Immortals-Robotics/Mikona/README.md

# ImmortalsMikona
Immortals kicker board known as Mikona
