Immortals-Robotics/Mikona/mikona.kicad_pcb

## KiCad design mikona.kicad_pcb (2024-02-27)

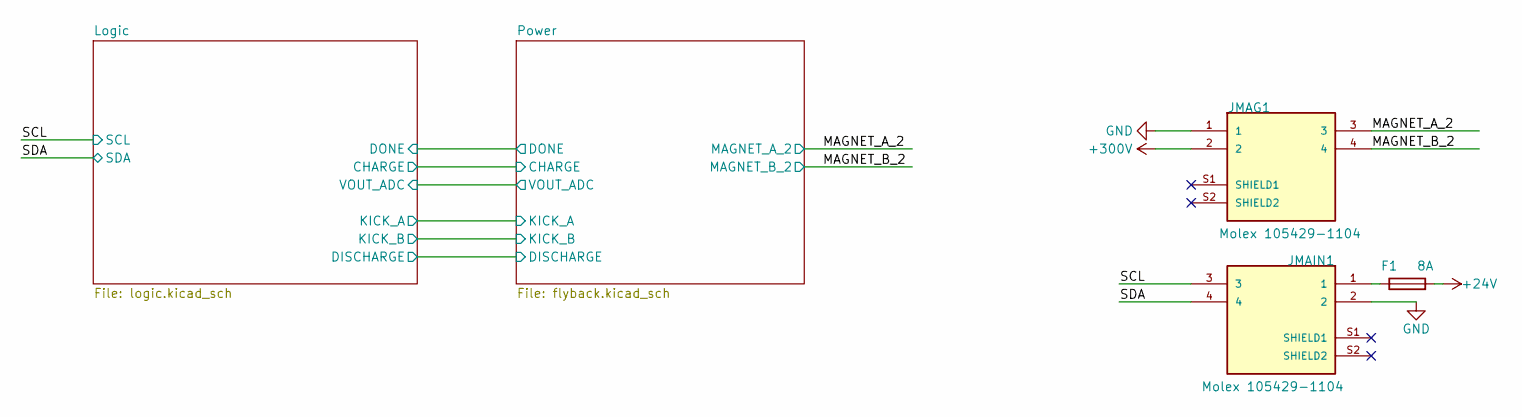
[picture p1: schematic mikona.kicad_sch]

Parts:
F1: 8A; Fuse_0603_1608Metric; MPN SF-0603SA800M-2
JMAG1: Molex 105429-1104; MOLEX_1054291104; MPN 1054291104
JMAIN1: Molex 105429-1104; MOLEX_1054291104; MPN 1054291104

Connections:
+24V: F1.2; also elsewhere on the board
/MAGNET_A_2: JMAG1.3; also elsewhere on the board
/MAGNET_B_2: JMAG1.4; also elsewhere on the board
/SCL: JMAIN1.3; also elsewhere on the board
/SDA: JMAIN1.4; also elsewhere on the board
GND: JMAG1.1, JMAIN1.2; also elsewhere on the board
unnamed: F1.1, JMAIN1.1
VDC: JMAG1.2; also elsewhere on the board

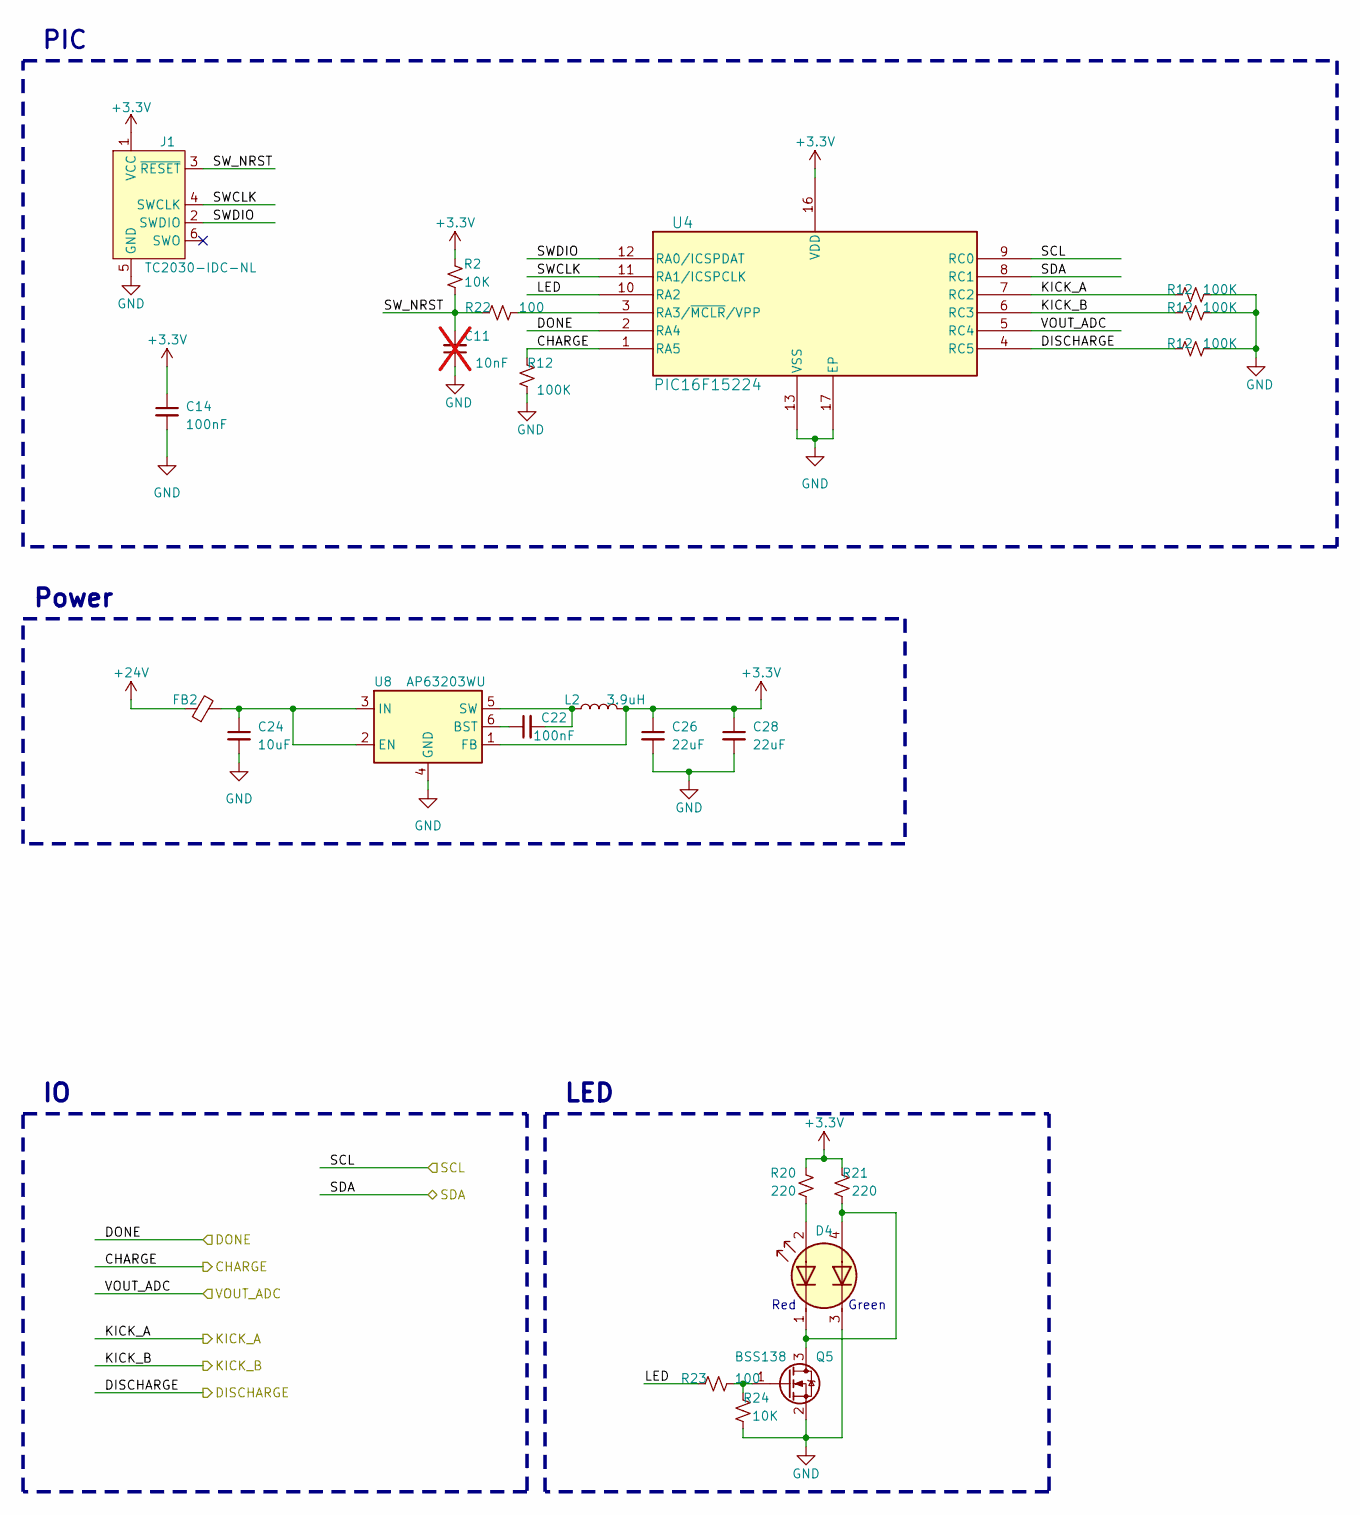
[picture p2: schematic logic.kicad_sch]

Parts:
C11: 10nF; C_0402_1005Metric; MPN 885012205067; not fitted
C14, C22: 100nF; C_0402_1005Metric; MPN GRM155R71H104KE14J
C24: 10uF; C_0603_1608Metric; MPN GRM188R6YA106MA73D
C26, C28: 22uF; C_0805_2012Metric; MPN CL21A226MPQNNNE
D4: LED Dual; LED_Avago_PLCC4_3.2x2.8mm_CW; MPN LTST-E682KRKGWT
FB2: FerriteBead_Small; R_0603_1608Metric; MPN BLM18KG101TN1D
J1: TC2030-IDC-NL; Tag-Connect_TC2030-IDC-NL_2x03_P1.27mm_Vertical; MPN TC2030-IDC-NL
L2: 3.9uH; L_Bourns-SRN6028; MPN SRN6028C-3R9M
Q5: BSS138; SOT-23; MPN BSS138-7-F
R2, R24: 10K; R_0402_1005Metric; MPN RC1005F103CS
R12: 100K; R_0402_1005Metric; MPN WR04X1003FTL
R20, R21: 220; R_0402_1005Metric; MPN ERJ-U02F2200X
R22, R23: 100; R_0402_1005Metric; MPN ERJ-2RKF1000X
U4: PIC16F15224; VQFN-16-1EP_3x3mm_P0.5mm_EP1.1x1.1mm; MPN PIC16F15224-I/MG
U8: AP63203WU; TSOT-23-6; MPN AP63203WU-7

Connections:
+3.3V: C14.1, C26.1, C28.1, J1.1 (VCC), L2.2, R2.2, R20.2, R21.2, U4.16 (VDD), U8.1 (FB); also elsewhere on the board
+24V: FB2.1; also elsewhere on the board
/Logic/CHARGE: U4.1 (RA5); also elsewhere on the board
/Logic/DISCHARGE: U4.4 (RC5); also elsewhere on the board
/Logic/DONE: U4.2 (RA4); also elsewhere on the board
/Logic/KICK_A: U4.7 (RC2); also elsewhere on the board
/Logic/KICK_B: U4.6 (RC3); also elsewhere on the board
/Logic/LED: R23.2, U4.10 (RA2)
/Logic/SWCLK: J1.4 (SWCLK), U4.11 (RA1/ICSPCLK)
/Logic/SWDIO: J1.2 (SWDIO), U4.12 (RA0/ICSPDAT)
/Logic/SW_NRST: C11.2, J1.3 (~RESET), R2.1, R22.2
/Logic/VOUT_ADC: U4.5 (RC4); also elsewhere on the board
/SCL: U4.9 (RC0); also elsewhere on the board
/SDA: U4.8 (RC1); also elsewhere on the board
GND: C11.1, C14.2, C24.2, C26.2, C28.2, D4.3 (A2), J1.5 (GND), Q5.2 (S), R24.1, U4.13 (VSS), U4.17 (EP), U8.4 (GND); also elsewhere on the board
unnamed: D4.1 (A1), D4.4 (K2), Q5.3 (D), R21.1
unnamed: D4.2 (K1), R20.1
unnamed: Q5.1 (G), R23.1, R24.2
unnamed: R22.1, U4.3 (RA3/~MCLR/VPP)
unnamed: C22.1, U8.6 (BST)
unnamed: C24.1, FB2.2, U8.2 (EN), U8.3 (IN)
unnamed: C22.2, L2.1, U8.5 (SW)

Notes on the sheet:
Green
Red
Power
PIC
LED

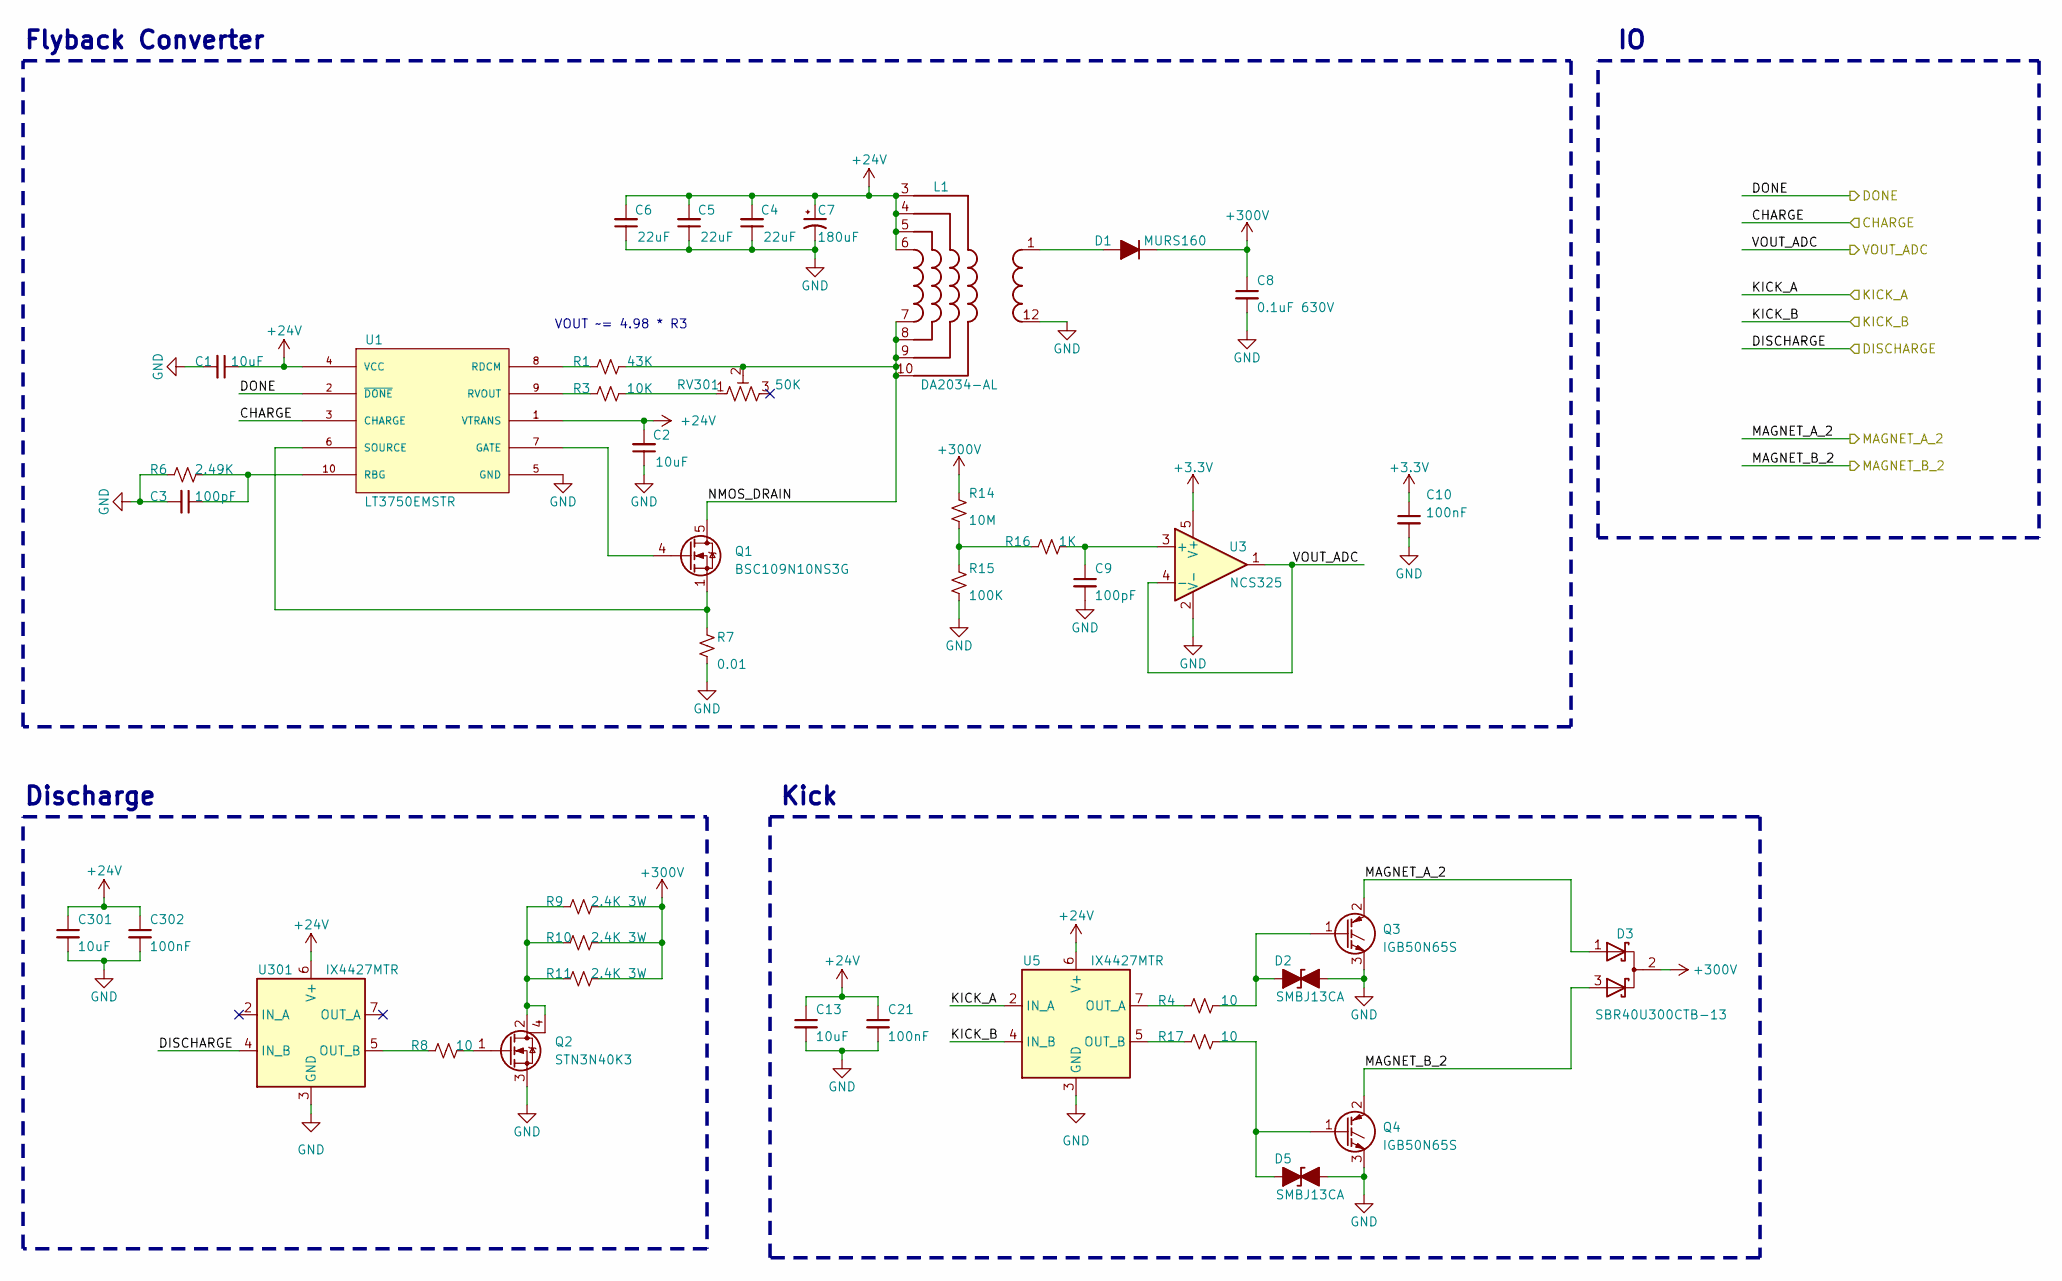
[picture p3: schematic flyback.kicad_sch]

Parts:
C1, C13, C301: 10uF; C_0805_2012Metric; MPN GRM21BR61H106KE43L
C2: 10uF; C_0603_1608Metric; MPN GRM188R6YA106MA73D
C3, C9: 100pF; C_0402_1005Metric; MPN 885012205055
C4, C5, C6: 22uF; C_1210_3225Metric; MPN GRM32ER71E226KE15L
C7: 180uF; CP_Elec_8x11.9; MPN 35SVPK180M
C8: 0.1uF 630V; C_1812_4532Metric; MPN C4532X7R2J104K230KA
C10, C21, C302: 100nF; C_0402_1005Metric; MPN GRM155R71H104KE14J
D1: MURS160; D_SMB; MPN MURS160A
D2, D5: SMBJ13CA; D_SMB; MPN SMBJ13CA-13-F
D3: SBR40U300CTB-13; TO-263-2; MPN SBR40U300CTB-13
L1: DA2034-AL; MPN DA2034-ALD
Q1: BSC109N10NS3G; TDSON-8-1; MPN BSC109N10NS3 G
Q2: STN3N40K3; SOT-223; MPN STN3N40K3
Q3, Q4: IGB50N65S; TO-263-2; MPN IGB50N65S5ATMA1
R1: 43K; R_0402_1005Metric; MPN CRCW040243K0JNED
R3: 10K; R_0402_1005Metric; MPN RC1005F103CS
R4, R8, R17: 10; R_0402_1005Metric; MPN ERJ-2RKF10R0X
R6: 2.49K; R_0402_1005Metric; MPN CR0402-FX-2491GLF
R7: 0.01; R_0805_2012Metric; MPN D1WKL0805MR010F-T5
R9, R10, R11: 2.4K 3W; R_2512_6332Metric; MPN 35222K4FT
R14: 10M; R_0603_1608Metric; MPN KTR03EZPF1005
R15: 100K; R_0402_1005Metric; MPN WR04X1003FTL
R16: 1K; R_0603_1608Metric; MPN RC0603FR-101KL
RV301: 50K; Potentiometer_Bourns_TC33X_Vertical; MPN TC33X-2-503E
U1: LT3750EMSTR; MSOP-10_MS; MPN LT3750EMS#TRPBF
U3: NCS325; SOT-23-5; MPN NCS325SN2T1G
U5, U301: IX4427MTR; DFN-8-1EP_3x3mm_P0.65mm_EP1.7x2.05mm; MPN IX4427MTR

Connections:
+3.3V: C10.1, U3.5 (V+); also elsewhere on the board
+24V: C1.1, C2.2, C4.2, C5.2, C6.2, C7.1, C13.1, C21.1, C301.1, C302.1, L1.3, L1.4, L1.5, L1.6, U1.1 (VTRANS), U1.4 (VCC), U5.6 (V+), U301.6 (V+); also elsewhere on the board
/Logic/CHARGE: U1.3 (CHARGE); also elsewhere on the board
/Logic/DISCHARGE: U301.4 (IN_B); also elsewhere on the board
/Logic/DONE: U1.2 (~DONE); also elsewhere on the board
/Logic/KICK_A: U5.2 (IN_A); also elsewhere on the board
/Logic/KICK_B: U5.4 (IN_B); also elsewhere on the board
/Logic/VOUT_ADC: U3.1, U3.4 (-); also elsewhere on the board
/MAGNET_A_2: D3.1 (K), Q3.2 (C); also elsewhere on the board
/MAGNET_B_2: D3.3 (K), Q4.2 (C); also elsewhere on the board
/Power/NMOS_DRAIN: L1.7, L1.8, L1.9, L1.10, Q1.5 (D), R1.1, RV301.2
GND: C1.2, C2.1, C3.2, C4.1, C5.1, C6.1, C7.2, C8.2, C9.2, C10.2, C13.2, C21.2, C301.2, C302.2, D2.2 (A2), D5.2 (A2), L1.12, Q2.3 (S), Q3.3 (E), Q4.3 (E), R6.2, R7.2, R15.2, U1.5 (GND), U3.2 (V-), U5.3 (GND), U301.3 (GND); also elsewhere on the board
unnamed: D1.2 (A), L1.1
unnamed: D2.1 (A1), Q3.1 (G), R4.1
unnamed: D5.1 (A1), Q4.1 (G), R17.1
unnamed: Q1.4 (G), U1.7 (GATE)
unnamed: Q2.2 (D), Q2.4 (D), R9.2, R10.2, R11.2
unnamed: Q2.1 (G), R8.1
unnamed: R3.1, RV301.1
unnamed: R14.2, R15.1, R16.2
unnamed: C3.1, R6.1, U1.10 (RBG)
unnamed: R1.2, U1.8 (RDCM)
unnamed: R3.2, U1.9 (RVOUT)
unnamed: Q1.1 (S), Q1.2 (S), Q1.3 (S), R7.1, U1.6 (SOURCE)
unnamed: C9.1, R16.1, U3.3 (+)
unnamed: R4.2, U5.7 (OUT_A)
unnamed: R17.2, U5.5 (OUT_B)
unnamed: R8.2, U301.5 (OUT_B)
VDC: C8.1, D1.1 (K), D3.2 (A), R9.1, R10.1, R11.1, R14.1; also elsewhere on the board

Notes on the sheet:
VOUT ~= 4.98 * R3
Kick
Flyback Converter
Discharge

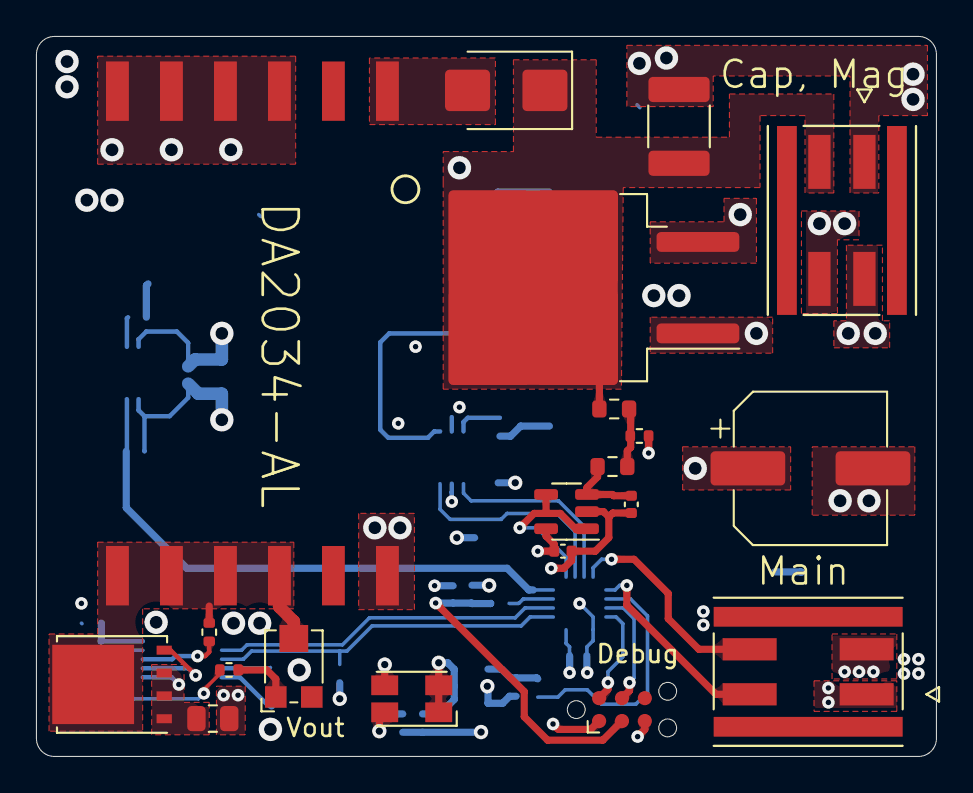
[picture p4: board mikona.kicad_pcb from above]

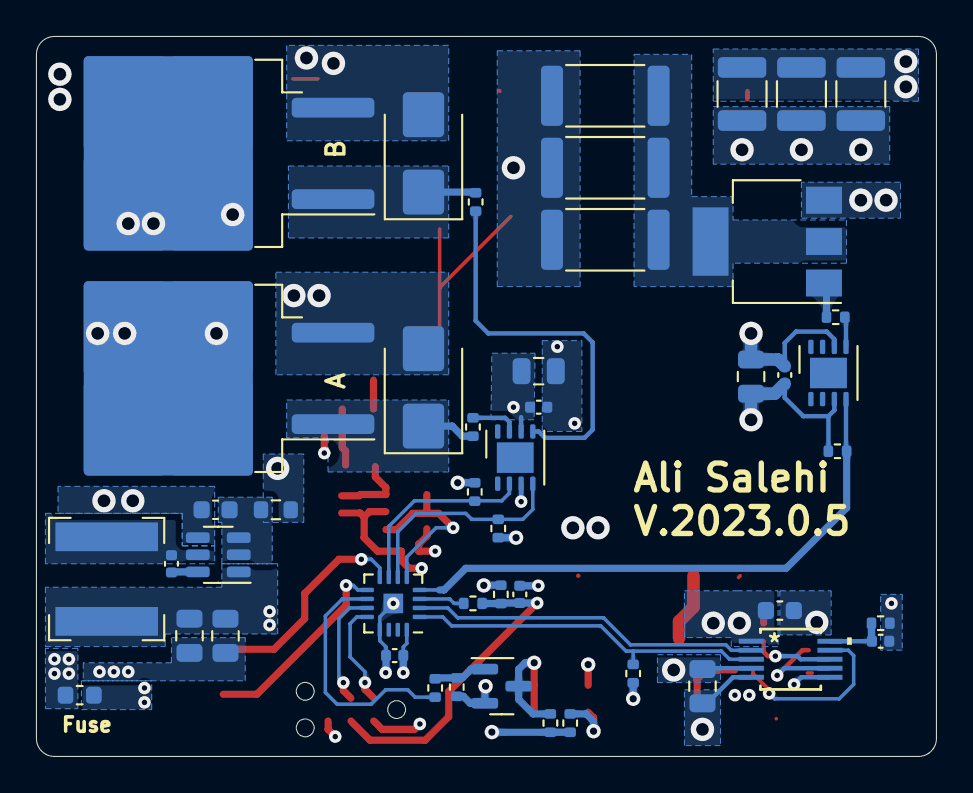
[picture p5: board mikona.kicad_pcb from below]

Board: 4 copper layers, 50.0 x 40.0 mm, 67 parts (47 on the bottom side), 43 nets.

Other parts of the board:
R5, R13, R18, R19: 100K; R_0402_1005Metric

Their connections:
/Logic/CHARGE: R19.2; also elsewhere on the board
/Logic/DISCHARGE: R18.2; also elsewhere on the board
/Logic/KICK_A: R5.2; also elsewhere on the board
/Logic/KICK_B: R13.2; also elsewhere on the board
GND: R5.1, R13.1, R18.1, R19.1; also elsewhere on the board
