Immortals-Robotics/Mikona/(commit log)

2023-03-02 Import the project from CircuitMaker.
    [arm.kicad_sch, flyback.kicad_sch, io.kicad_sch, kick.kicad_sch, mikona.kicad_pcb, mikona.kicad_sch]
2023-03-06 Cleanup the project after moving to KiCad.
    [arm.kicad_sch, flyback.kicad_sch, io.kicad_sch, kick.kicad_sch, mikona.kicad_pcb, mikona.kicad_sch]
2023-03-06 Add missing 3d models.
    [arm.kicad_sch, flyback.kicad_sch, mikona.kicad_pcb]
2023-03-17 Finish the layout, remove old routings, and setup internal planes.
    [arm.kicad_sch, flyback.kicad_sch, mikona.kicad_pcb, mikona.kicad_sch]
2023-03-17 Finish the draft routing.
    [arm.kicad_sch, mikona.kicad_pcb, mikona.kicad_sch]
2023-03-17 Move a lot of vias out of pads as this is an expensive option when manufacturing the PCB.
    [mikona.kicad_pcb]
2023-04-08 Add jlpcb rules and fix many violations.
    [arm.kicad_sch, mikona.kicad_pcb]
2023-04-08 Move the flash mem to bottom layer, we're now error-free, yay :D
    [mikona.kicad_pcb]
2023-04-10 Improve routing, almost there.
    [mikona.kicad_pcb]
2023-04-12 Remove 2 unused tracks.
    [mikona.kicad_pcb]
2023-04-12 Organize silkscreen and improve power layer.
    [mikona.kicad_pcb]
2023-04-14 Improve regulator routing.
    [arm.kicad_sch, mikona.kicad_pcb]
2023-04-14 Fix minimum via hole size violations.
    [mikona.kicad_pcb]
2023-05-01 Update MPNs and add jlcpcb comments.
    [arm.kicad_sch, flyback.kicad_sch, mikona.kicad_pcb, mikona.kicad_sch]
2023-05-02 Add teardrops and version text.
    [mikona.kicad_pcb]
2023-05-28 Move from stm32 to pic16 and remove other unnecessary parts.
    [arm.kicad_sch, flyback.kicad_sch, logic.kicad_sch, mikona.kicad_pcb, mikona.kicad_sch]
2023-05-28 Finish routing.
    [logic.kicad_sch, mikona.kicad_pcb]
2023-05-28 Minor fixes to the PCB.
    [mikona.kicad_pcb]
2023-05-28 Remove an unused config file.
    [mikona.kicad_pcb]
2023-05-28 Use the correct package for 4427.
    [flyback.kicad_sch, mikona.kicad_pcb]
2023-06-09 Fix issues found during testing.
    [flyback.kicad_sch, logic.kicad_sch, mikona.kicad_pcb]
2023-06-09 Use parts similar to motor-driver where possible.
    [flyback.kicad_sch, logic.kicad_sch, mikona.kicad_pcb]
2023-06-09 Use parts similar to the main pcb where possible.
    [flyback.kicad_sch, mikona.kicad_pcb]
2023-06-09 Add missing MPNs.
    [flyback.kicad_sch, logic.kicad_sch, mikona.kicad_pcb]
2023-06-11 Change the parts that were not in stock.
    [flyback.kicad_sch, logic.kicad_sch, mikona.kicad_sch]
2023-06-11 Apply the MPN changes to the PCB.
    [mikona.kicad_pcb]
